tomirendo/lab_repo/opendacs.com/dac-adc-homepage/specifications/index.html

# openDACs



# Specifications

- Schematic:

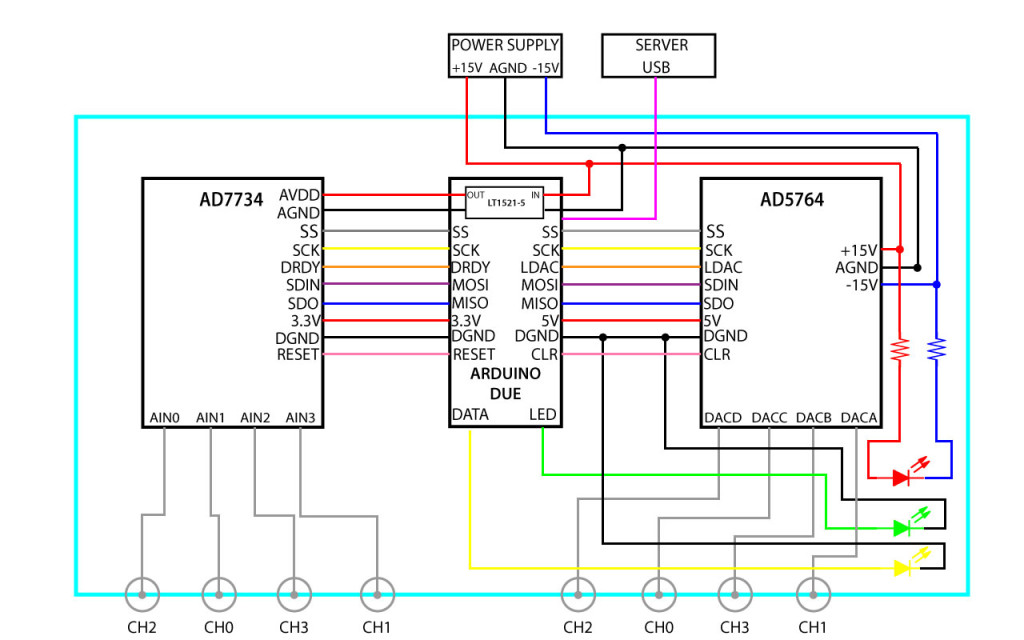
[picture p1: opendacs.com/wp-content/uploads/2015/10/DAC-ADC_AD5764-AD7734_Schematics-1024x640.jpg]
DAC-ADC_AD5764-AD7734_Schematics


- DAC: Analog Devices AD5764 (http://www.analog.com/en/products/digital-to-analog-converters/da-converters/ad5764.html)
- ADC: Analog Devices AD7734 (http://www.analog.com/en/products/analog-to-digital-converters/ad-converters/ad7734.html)
- Input Power Supply: +/- 15V
- Number of output channels: 4
- Number of input channels: 4
- Range of output channels: -10V to 10V
- Operations:
  - “*IDN?”
  - “*RDY?”
  - “SET”
  - “GET_ADC”
  - “RAMP1″
  - “RAMP2″
  - “BUFFER_RAMP”
  - “CONVERT_TIME”
- What is openDACs?
- Seekat(Arduino UNO) Homepage
- Seekat(Arduino Due) Homepage
- DAC-ADC Homepage
- Seekat Quad-AD5780
- About us
- Feedback – Tell us what we should do next!

Proudly powered by WordPress (http://wordpress.org/) | Theme Mimbolove (http://mimbolove.wordpress.com)

openDACs :
