tomirendo/lab_repo/opendacs.com/seekat_quad_ad5780/specifications/index.html

# openDACs



# Specifications

- DAC: Analog Devices AD5780 (http://www.analog.com/media/en/technical-documentation/data-sheets/AD5780.pdf)
- Input Power Supply: +/- 15V
- Number of output channels: 4
- Range of output channels: -10V to 10V
- Operations:
  - “*IDN?”
  - “*RDY?”
  - “SET”
  - “GET_DAC”
  - “RAMP1″
  - “RAMP2″
- What is openDACs?
- Seekat(Arduino UNO) Homepage
- Seekat(Arduino Due) Homepage
- DAC-ADC Homepage
- Seekat Quad-AD5780
- About us
- Feedback – Tell us what we should do next!

Proudly powered by WordPress (http://wordpress.org/) | Theme Mimbolove (http://mimbolove.wordpress.com)

openDACs :
