tomirendo/lab_repo/opendacs.com/wp-content/uploads/2014/08/J21-connections.png

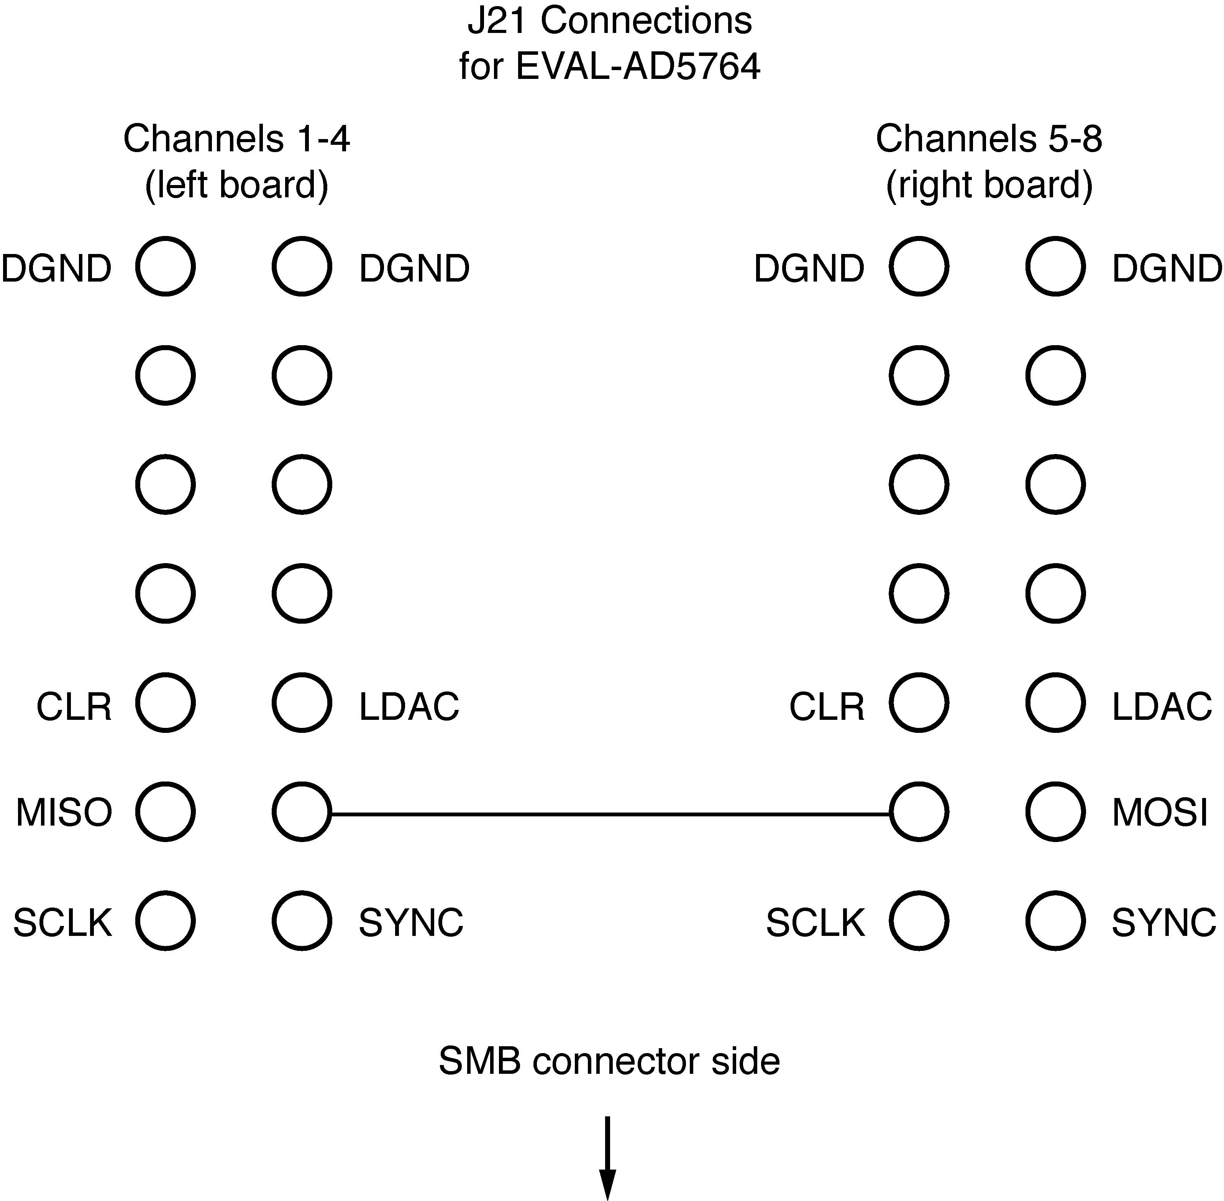
opendacs.com/wp-content/uploads/2014/08/J21-connections.png
