tomirendo/lab_repo/opendacs.com/wp-content/uploads/2014/08/Photo-Aug-20-11-26-08-AM.jpg

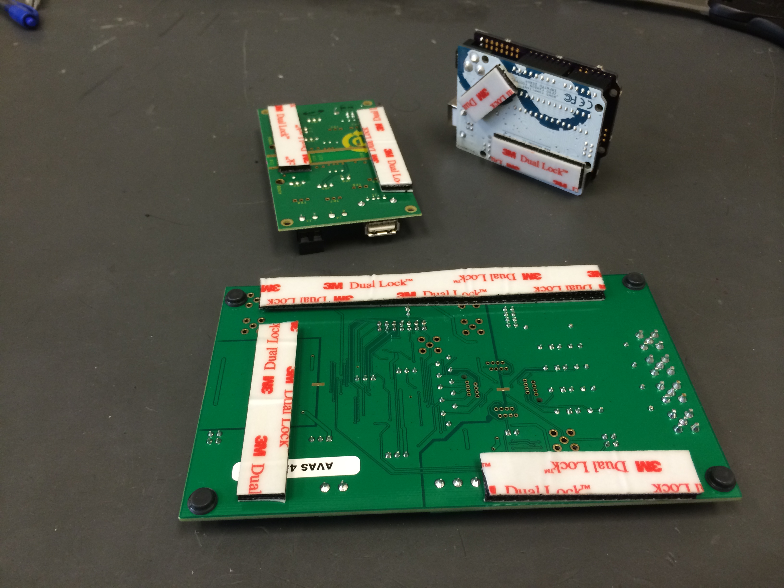
opendacs.com/wp-content/uploads/2014/08/Photo-Aug-20-11-26-08-AM.jpg
