tomirendo/lab_repo/opendacs.com/wp-content/uploads/2014/08/Seekat-LED-close-up.jpg

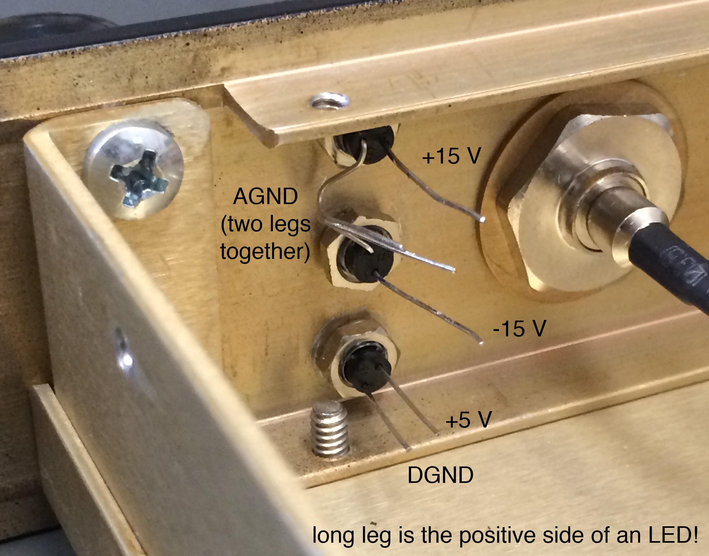
opendacs.com/wp-content/uploads/2014/08/Seekat-LED-close-up.jpg
