tomirendo/lab_repo/opendacs.com/wp-content/uploads/2014/08/Seekat-LED-Power1.jpg

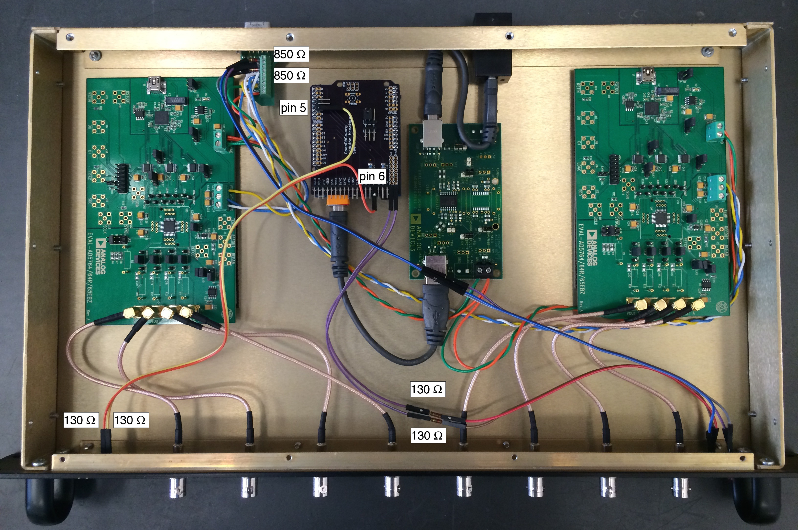
opendacs.com/wp-content/uploads/2014/08/Seekat-LED-Power1.jpg
