tomirendo/lab_repo/opendacs.com/wp-content/uploads/2014/08/Seekat-Power-Connections_v3.jpg

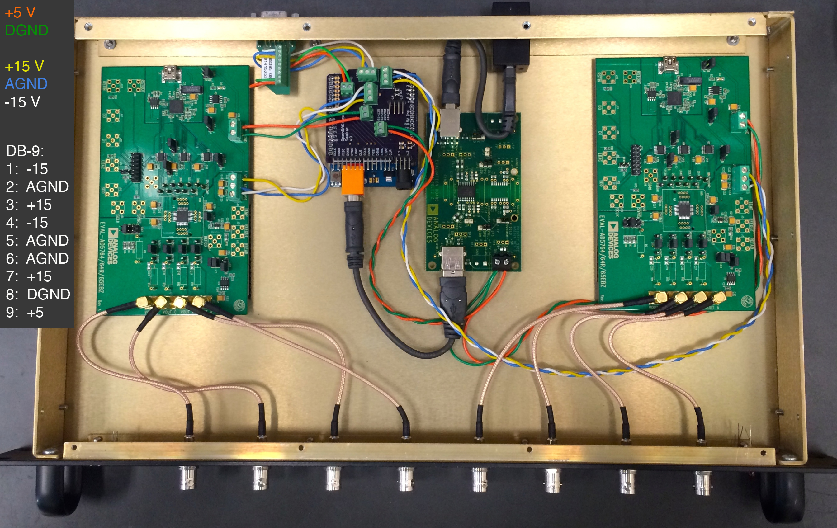
opendacs.com/wp-content/uploads/2014/08/Seekat-Power-Connections_v3.jpg
