tomirendo/lab_repo/opendacs.com/wp-content/uploads/2014/08/Seekat-Schematic-01.png

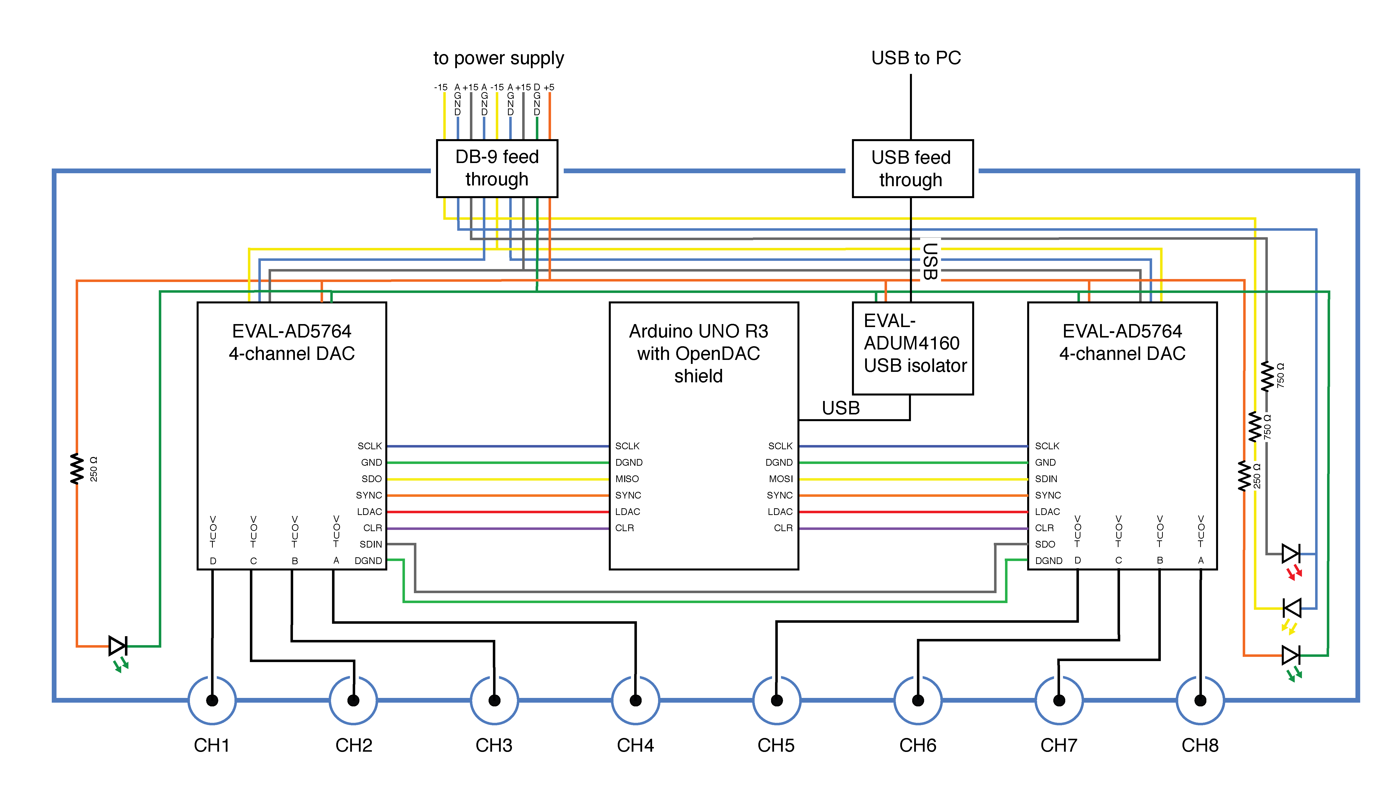
opendacs.com/wp-content/uploads/2014/08/Seekat-Schematic-01.png
