tomirendo/lab_repo/opendacs.com/wp-content/uploads/2014/08/Seekat-Schematic_v3-01.png

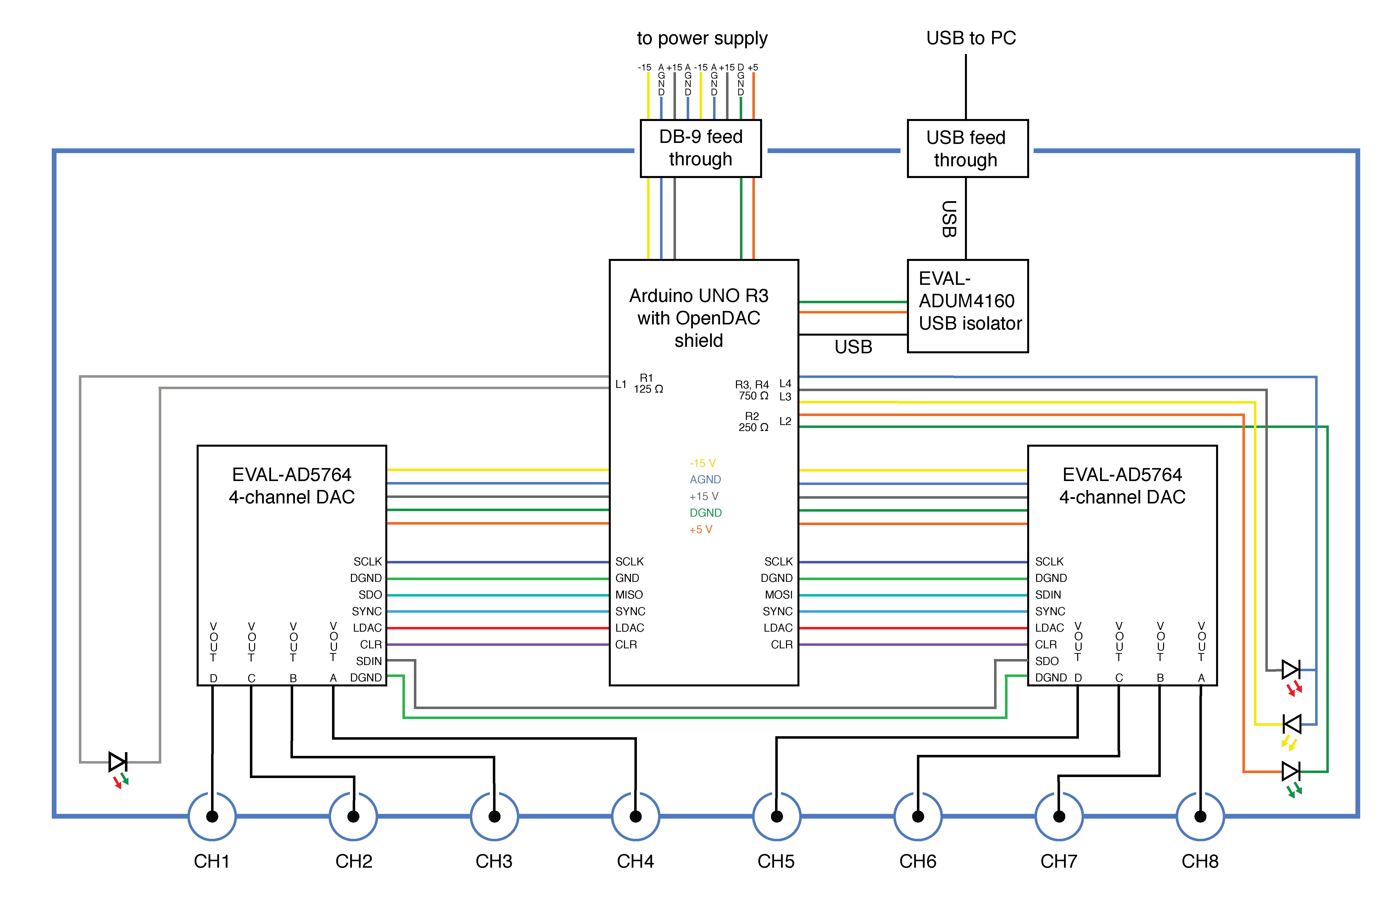
opendacs.com/wp-content/uploads/2014/08/Seekat-Schematic_v3-01.png
