tomirendo/lab_repo/opendacs.com/wp-content/uploads/2014/09/IMG_4638.jpg

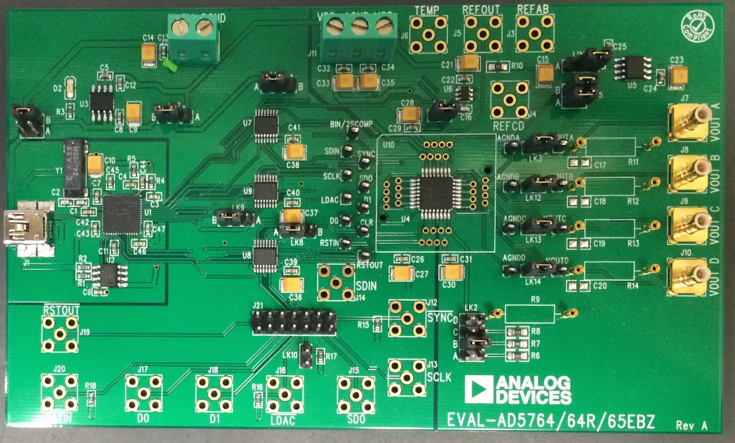
opendacs.com/wp-content/uploads/2014/09/IMG_4638.jpg
