tomirendo/lab_repo/opendacs.com/wp-content/uploads/2015/09/image1-5.jpg

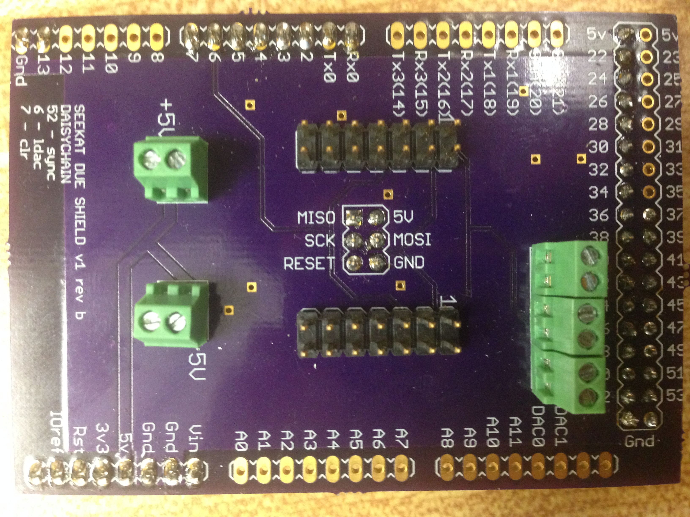
opendacs.com/wp-content/uploads/2015/09/image1-5.jpg
