tomirendo/lab_repo/opendacs.com/wp-content/uploads/2015/09/image1-6.jpg

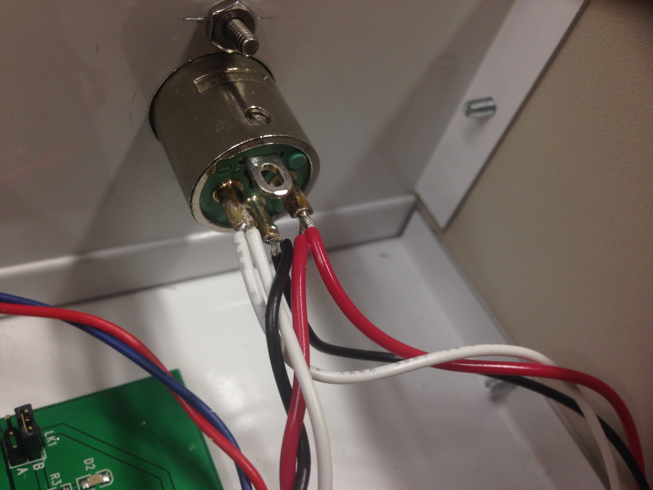
opendacs.com/wp-content/uploads/2015/09/image1-6.jpg
