tomirendo/lab_repo/opendacs.com/wp-content/uploads/2015/09/image2-2.jpg

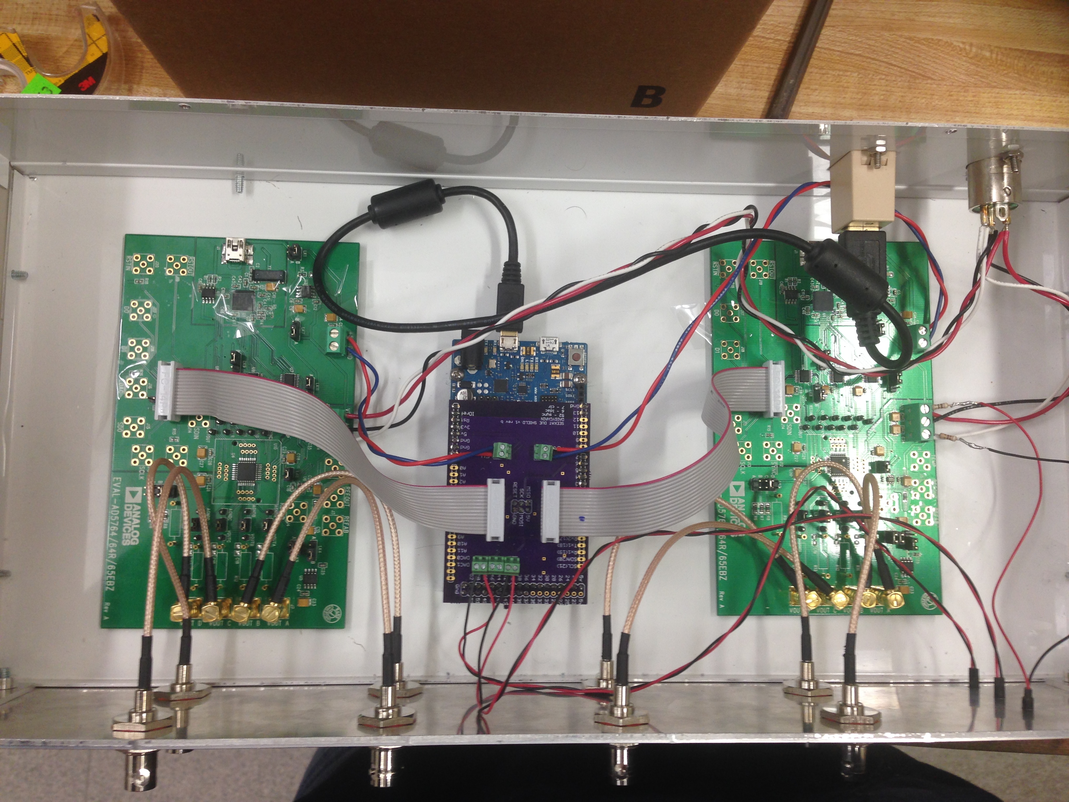
opendacs.com/wp-content/uploads/2015/09/image2-2.jpg
