tomirendo/lab_repo/opendacs.com/wp-content/uploads/2015/10/AD7734-Board.jpg

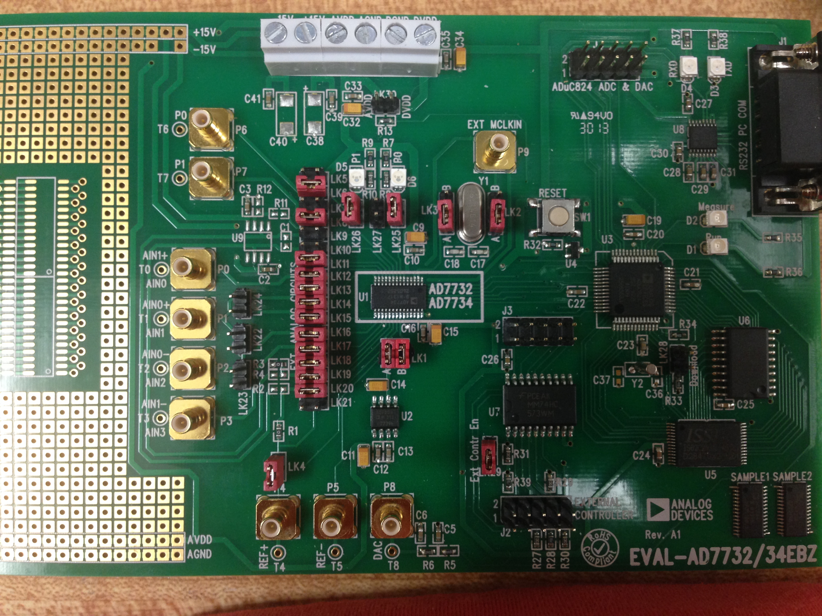
opendacs.com/wp-content/uploads/2015/10/AD7734-Board.jpg
