tomirendo/lab_repo/opendacs.com/wp-content/uploads/2015/10/DAC-ADC_Comm.jpg

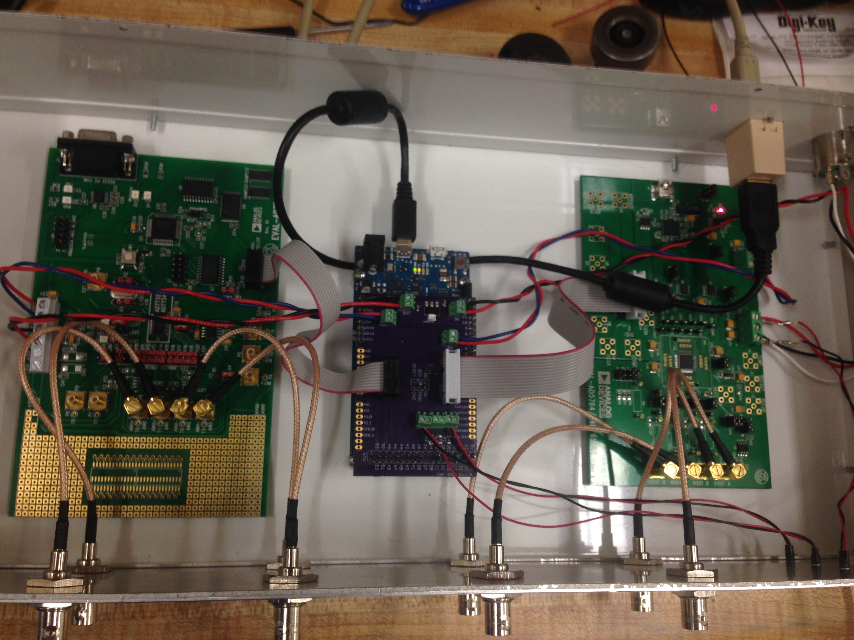
opendacs.com/wp-content/uploads/2015/10/DAC-ADC_Comm.jpg
