tomirendo/lab_repo/opendacs.com/wp-content/uploads/2015/10/Power_connections.jpg

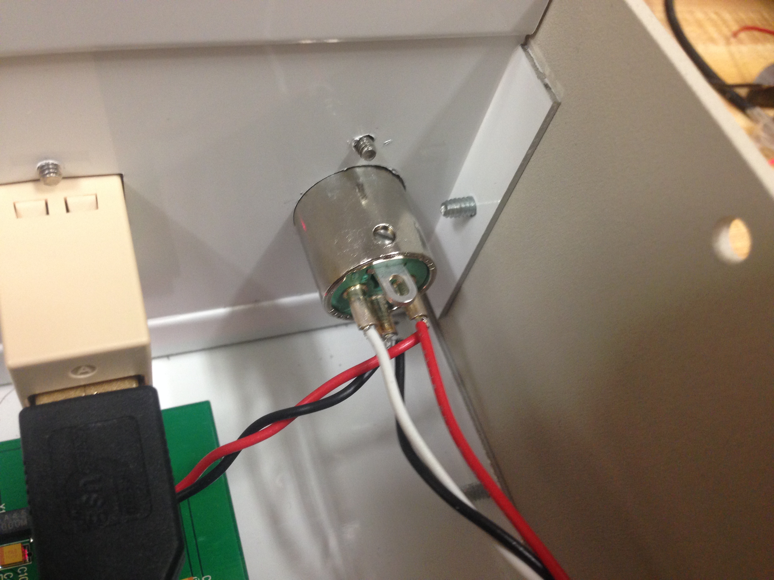
opendacs.com/wp-content/uploads/2015/10/Power_connections.jpg
