tomirendo/lab_repo/opendacs.com/wp-content/uploads/2014/08/Power-and-LED-wiring_v3.jpg

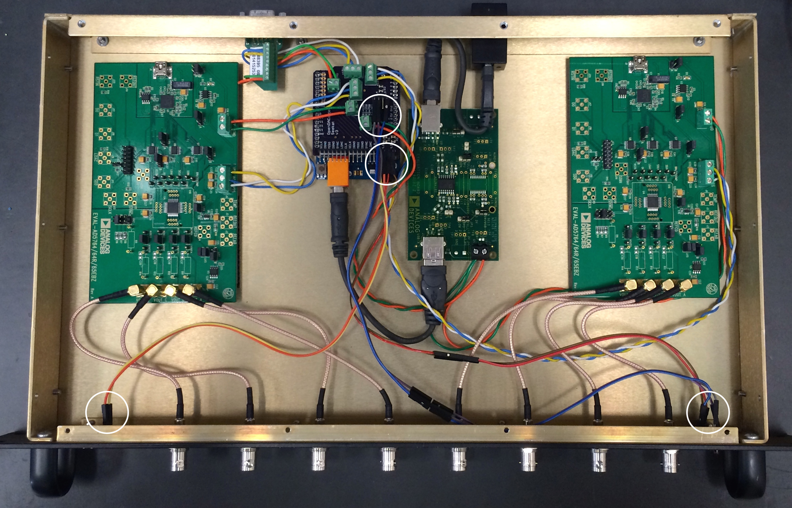
opendacs.com/wp-content/uploads/2014/08/Power-and-LED-wiring_v3.jpg
