tomirendo/lab_repo/opendacs.com/wp-content/uploads/2014/08/Seekat-Comms-Wiring.jpg

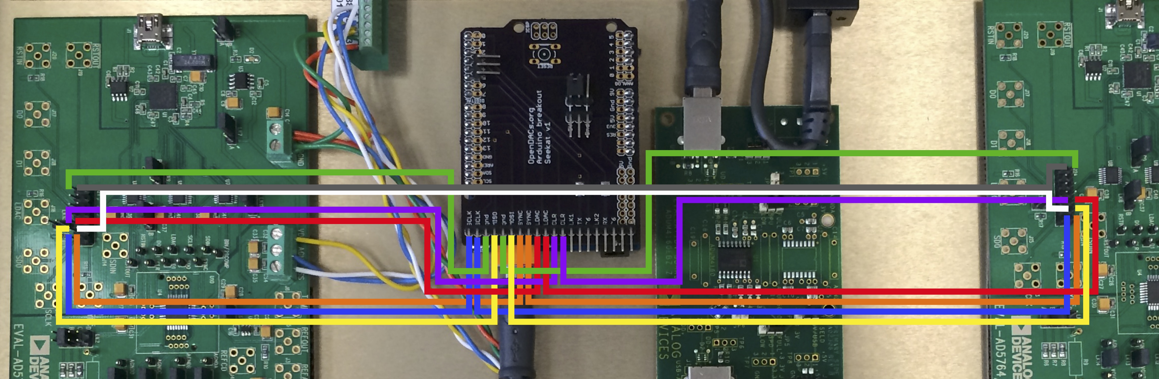
opendacs.com/wp-content/uploads/2014/08/Seekat-Comms-Wiring.jpg
