tomirendo/lab_repo/opendacs.com/seekat-homepage/seekat-calibration/index.html

# openDACs



# Seekat Matlab code for offset and gain calibration

%plug the channel to be calibrated into a DMM. You will need to have some function of your own to read the DMM voltage.

function[] = calibrateSeekat(channel)

global a

switch channel

case 1

n1 = 19;

n2=0;

m1=1;

m2=0;

case 2

n1 = 18;

n2=0;

m1=1;

m2=0;

case 3

n1 = 17;

n2=0;

m1=1;

m2=0;

case 4

n1 = 16;

n2=0;

m1=1;

m2=0;

case 5

n1 = 0;

n2=19;

m1=0;

m2=1;

case 6

n1 = 0;

n2=18;

m1=0;

m2=1;

case 7

n1 = 0;

n2=17;

m1=0;

m2=1;

case 8

n1 = 0;

n2=16;

m1=0;

m2=1;

otherwise

disp(‘INVALID CHANNEL’)

end

fwrite(a,[255,254,253,n1+24,0,0,n2+24,0,0]); %zero the offset register

fwrite(a,[255,254,253,n1+16,0,0,n2+16,0,0]); %zero the gain register

measuredValues = zeros(2,1);

voltage = 0;

if voltage >= 0

dec16 = round((2^15-1)*voltage/10); %Decimal equivalent of 16 bit data

else

dec16 = round(2^16 – abs(voltage)/10 * 2^15); %Decimal equivalent of 16 bit data

end

bin16 = de2bi(dec16,16,2,‘left-msb’); %16 bit binary

d1=bi2de(fliplr(bin16(1:8))); %first 8 bits

d2=bi2de(fliplr(bin16(9:16))); %second 8 bits

%disp([255,254,253,n1,d1*m1,d2*m1,n2,d1*m2,d2*m2]);

pause(.005);

fwrite(a,[255,254,253,n1,d1*m1,d2*m1,n2,d1*m2,d2*m2]);

while a.BytesAvailable

fscanf(a,‘%e’);

end

pause(2)

blah = smget(‘V’); %your code here to read voltage

offset = -blah{1};

offsetsteps = round(offset/(38.14e-6));

offset8 = de2bi(mod((offsetsteps),2^8),8,‘left-msb’);

d1=0;%bi2de(fliplr(bin16(1:8))); %first 8 bits

d2=bi2de(fliplr(offset8));%bi2de(fliplr(bin16(9:16))); %second 8 bits

%disp([255,254,253,n1,d1*m1,d2*m1,n2,d1*m2,d2*m2])

pause(.005);

fwrite(a,[255,254,253,n1+24,d1*m1,d2*m1,n2+24,d1*m2,d2*m2]); % +24 to access offset register

while a.BytesAvailable

fscanf(a,‘%e’);

end

pause(1)

voltage = -10;

if voltage >= 0

dec16 = round((2^15-1)*voltage/10); %Decimal equivalent of 16 bit data

else

dec16 = round(2^16 – abs(voltage)/10 * 2^15); %Decimal equivalent of 16 bit data

end

bin16 = de2bi(dec16,16,2,‘left-msb’); %16 bit binary

d1=bi2de(fliplr(bin16(1:8))); %first 8 bits

d2=bi2de(fliplr(bin16(9:16))); %second 8 bits

%disp([255,254,253,n1,d1*m1,d2*m1,n2,d1*m2,d2*m2]);

pause(.005);

fwrite(a,[255,254,253,n1,d1*m1,d2*m1,n2,d1*m2,d2*m2]);

while a.BytesAvailable

fscanf(a,‘%e’);

end

pause(2)

blah = smget(‘V’); %your code here to read voltage

gainerror = blah{1}+10;

gainsteps = round(gainerror/(152.59e-6));

gain8 = de2bi(mod((gainsteps),2^8),8,‘left-msb’);

%bin16 = de2bi(gain16,16,2,’left-msb’); %16 bit binary

d1=0;%bi2de(fliplr(gain16(1:8))) %first 8 bits

d2=bi2de(fliplr(gain8));%bi2de(fliplr(gain8(1:8))) %second 8 bits

pause(.005);

fwrite(a,[255,254,253,n1+16,d1*m1,d2*m1,n2+16,d1*m2,d2*m2]); % +16 to access gain register instead of data register

while a.BytesAvailable

fscanf(a,‘%e’);

end

pause(1)

voltage = 0;

if voltage >= 0

dec16 = round((2^15-1)*voltage/10); %Decimal equivalent of 16 bit data

else

dec16 = round(2^16 – abs(voltage)/10 * 2^15); %Decimal equivalent of 16 bit data

end

bin16 = de2bi(dec16,16,2,‘left-msb’); %16 bit binary

d1=bi2de(fliplr(bin16(1:8))); %first 8 bits

d2=bi2de(fliplr(bin16(9:16))); %second 8 bits

%disp([255,254,253,n1,d1*m1,d2*m1,n2,d1*m2,d2*m2]);

pause(.005);

fwrite(a,[255,254,253,n1,d1*m1,d2*m1,n2,d1*m2,d2*m2]);

while a.BytesAvailable

fscanf(a,‘%e’);

end

end

- What is openDACs?
- Seekat(Arduino UNO) Homepage
- Seekat(Arduino Due) Homepage
- DAC-ADC Homepage
- Seekat Quad-AD5780
- About us
- Feedback – Tell us what we should do next!

Proudly powered by WordPress (http://wordpress.org/) | Theme Mimbolove (http://mimbolove.wordpress.com)

openDACs :
