tomirendo/lab_repo/(commit log)

2016-06-21 implemented basic device protocol
2016-08-01 Fully running device + sine +sineRamp
2016-08-09 Some fixes to sine_read, not done yet
    [Full_Code.ino]
2016-08-11 arduino is reading ADC again
